RainbowneckEngineering/High-Power-RGBW-LED-Lighting/P-LED-0003-V1A PDF Schematic.pdf

# LED1 PAD

# LED2 PAD

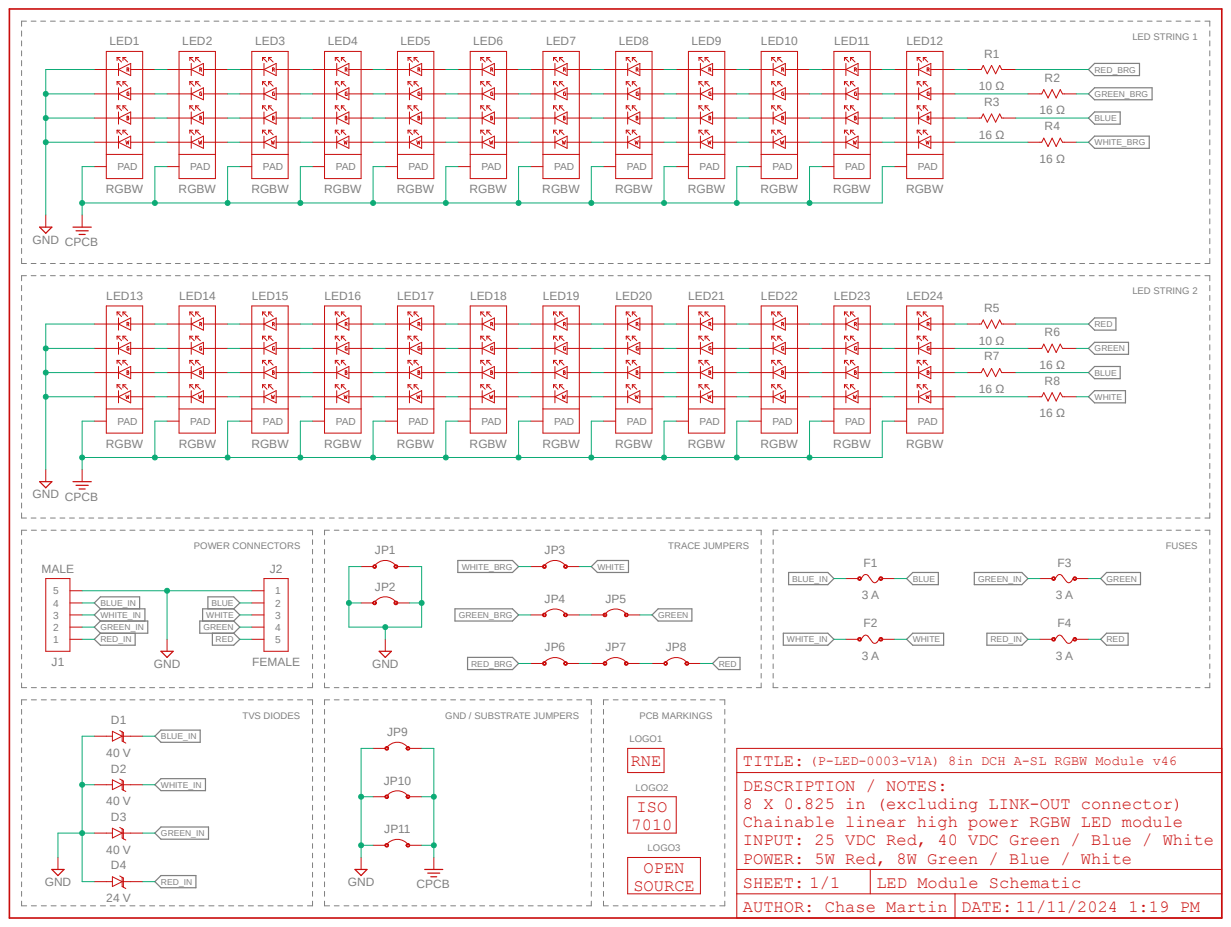
[picture p1: page 1]

TITLE:
DESCRIPTION / NOTES:
8 X 0.825 in (excluding LINK-OUT connector)
Chainable linear high power RGBW LED module
INPUT: 25 VDC Red, 40 VDC Green / Blue / White
POWER: 5W Red, 8W Green / Blue / White

(P-LED-0003-V1A) 8in DCH A-SL RGBW Module v46

SHEET: 1/1 | LED Module Schematic
AUTHOR: Chase Martin | DATE: 11/11/2024 1:19 PM
