RainbowneckEngineering/High-Power-RGBW-LED-Lighting/P-LED-0004-V1A PDF Schematic.pdf

## LED1 PAD

## LED2 PAD

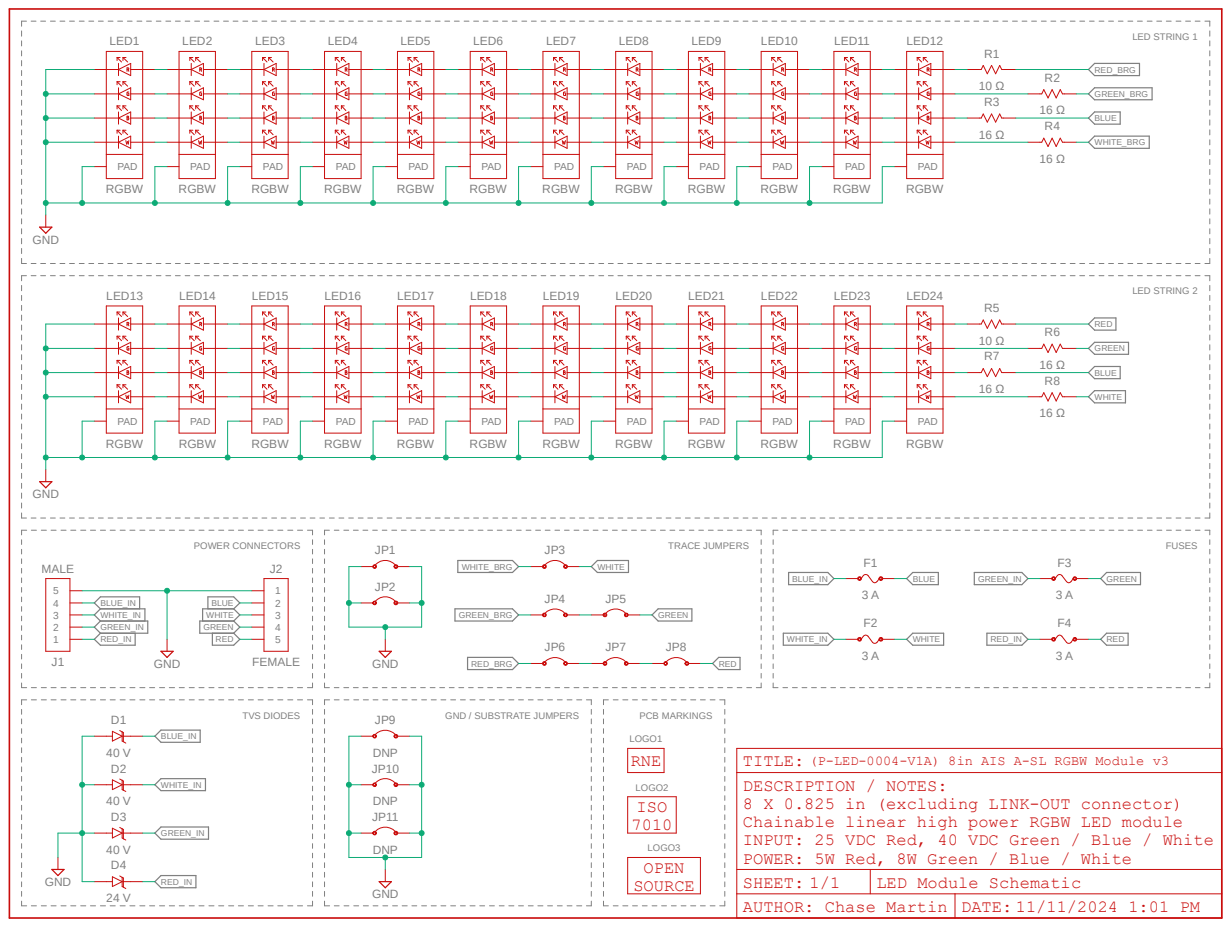
[picture p2: page 1]
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

(P-LED-0004-V1A) 8in AIS A-SL RGBW Module v3

SHEET: 1/1 | LED Module Schematic
AUTHOR: Chase Martin | DATE: 11/11/2024 1:01 PM
