RainbowneckEngineering/High-Power-RGBW-LED-Lighting/P-LED-0003-V1A EAGLE Board.brd

## EAGLE design P-LED-0003-V1A EAGLE Board.brd (2024-11-11)

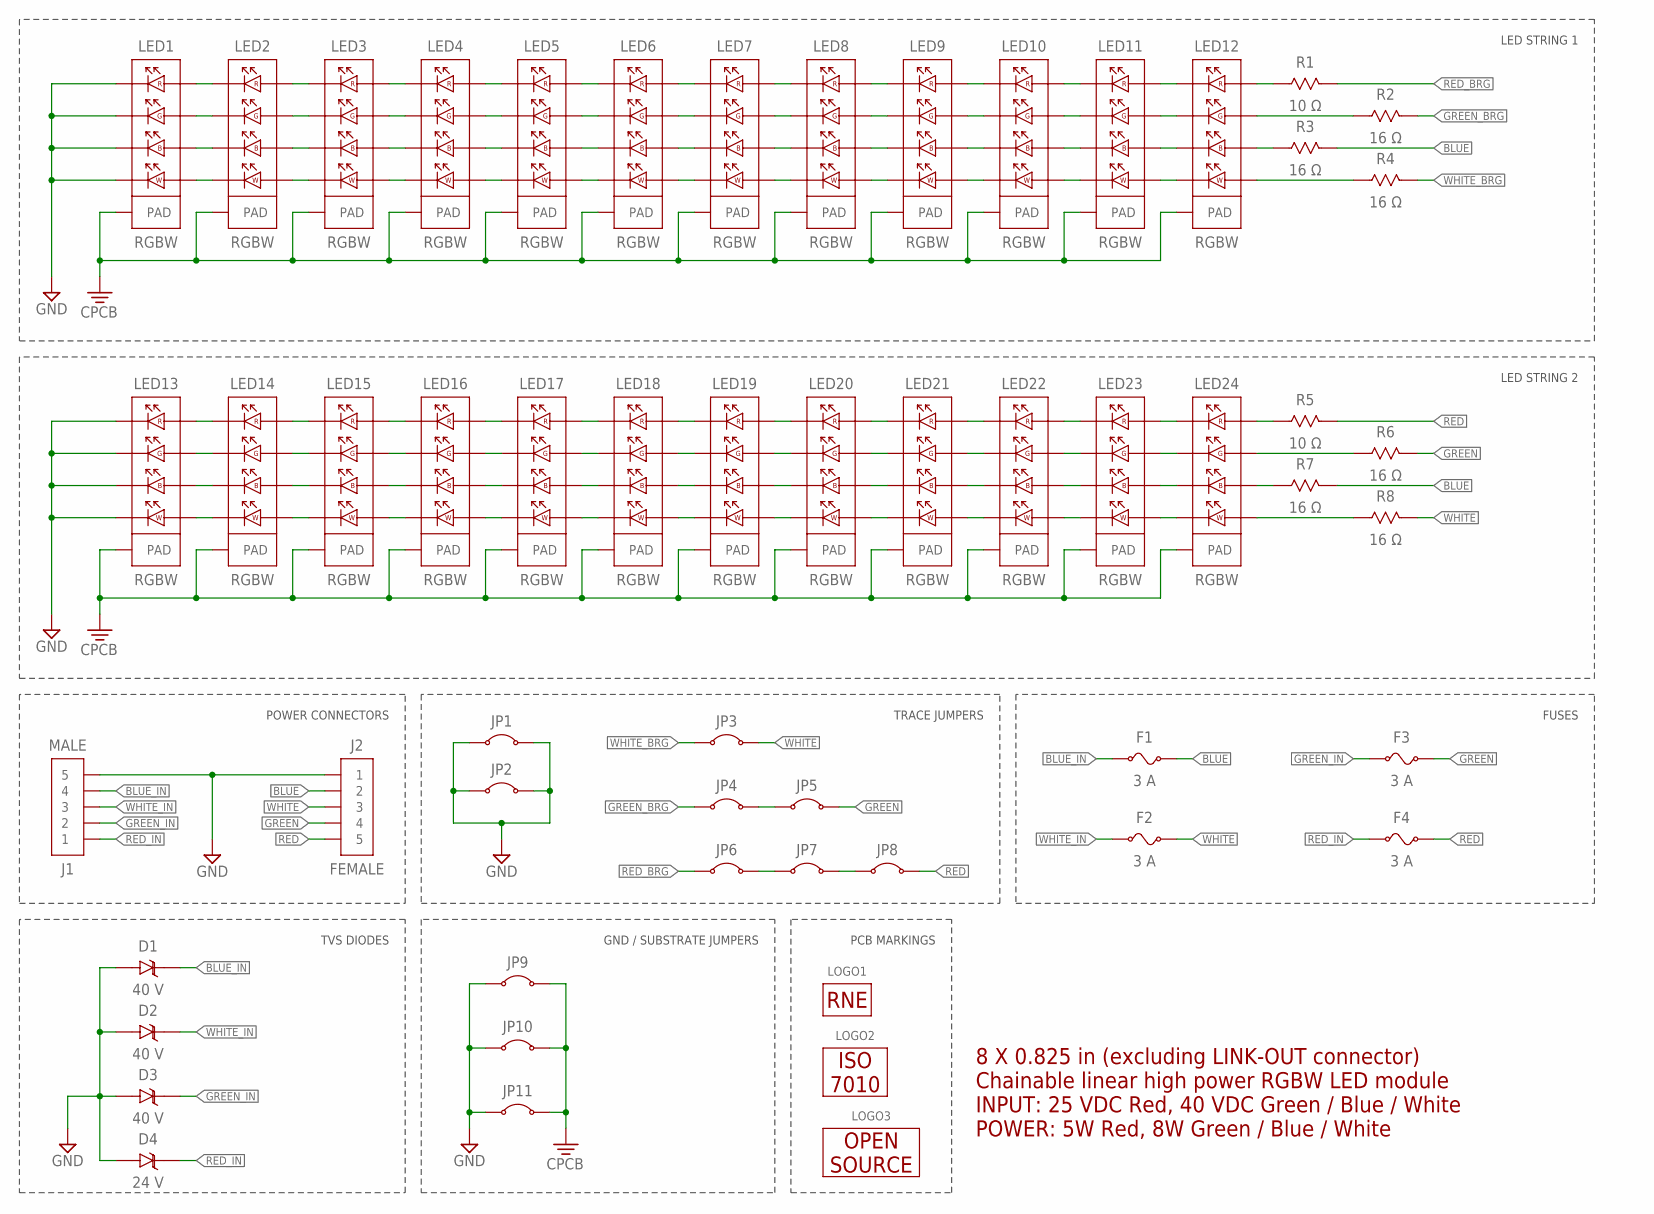
[picture p4: schematic P-LED-0003-V1A EAGLE Schematic.sch, LED Module Schematic]

Parts:
D1, D2, D3: 40 V; 0603_POLARIZED
D4: 24 V; 0603_POLARIZED
F1, F2, F3, F4: 3 A; 1206
J1: MALE; 5-PIN_1-ROW_MALE_SMD_HORIZONTAL
J2: FEMALE; 5-PIN_1-ROW_FEMALE_SMD_HORIZONTAL
JP1, JP2, JP3, JP4, JP5, JP6, JP7, JP8: JUMPERSMD_1206; 1206
JP9, JP10, JP11: DCH_JUMPERSMD_0603; 0603
LED1, LED2, LED3, LED4, LED5, LED6, LED7, LED8, LED9, LED10, LED11, LED12, LED13, LED14, LED15, LED16, LED17, LED18, LED19, LED20, LED21, LED22, LED23, LED24: RGBW; IN-P55QSTGRGBW
LOGO1: PROFILE_LOGO_RNE0.375"; RNE_PROFILE-LOGO_375
LOGO2: HOT_SURFACE_ISO0.375"_LABEL; ISO_HOT-SURFACE_375_LABEL
LOGO3: OPEN_SOURCE_OSHWA0.375"_LABEL; OSHWA_OPEN-SOURCE_375_LABEL
R1, R5: 10 Ω; 0603
R2, R3, R4, R6, R7, R8: 16 Ω; 0603

Connections:
B1_RESISTOR: LED12.BLUE_P, R3.1
B2_RESISTOR: LED24.BLUE_P, R7.1
BLUE: F1.2, J2.2, R3.2, R7.2
BLUE_IN: D1.K, F1.1, J1.4
B_12: LED1.BLUE_P, LED2.BLUE_N
B_23: LED2.BLUE_P, LED3.BLUE_N
B_34: LED3.BLUE_P, LED4.BLUE_N
B_45: LED4.BLUE_P, LED5.BLUE_N
B_56: LED5.BLUE_P, LED6.BLUE_N
B_67: LED6.BLUE_P, LED7.BLUE_N
B_78: LED7.BLUE_P, LED8.BLUE_N
B_89: LED8.BLUE_P, LED9.BLUE_N
B_910: LED9.BLUE_P, LED10.BLUE_N
B_1011: LED10.BLUE_P, LED11.BLUE_N
B_1112: LED11.BLUE_P, LED12.BLUE_N
B_1314: LED13.BLUE_P, LED14.BLUE_N
B_1415: LED14.BLUE_P, LED15.BLUE_N
B_1516: LED15.BLUE_P, LED16.BLUE_N
B_1617: LED16.BLUE_P, LED17.BLUE_N
B_1718: LED17.BLUE_P, LED18.BLUE_N
B_1819: LED18.BLUE_P, LED19.BLUE_N
B_1920: LED19.BLUE_P, LED20.BLUE_N
B_2021: LED20.BLUE_P, LED21.BLUE_N
B_2122: LED21.BLUE_P, LED22.BLUE_N
B_2223: LED22.BLUE_P, LED23.BLUE_N
B_2324: LED23.BLUE_P, LED24.BLUE_N
G1_RESISTOR: LED12.GREEN_P, R2.1
G2_RESISTOR: LED24.GREEN_P, R6.1
GREEN: F3.2, J2.4, JP5.2, R6.2
GREEN_BRG: JP4.1, R2.2
GREEN_BRG_2: JP4.2, JP5.1
GREEN_IN: D3.K, F3.1, J1.2
G_12: LED1.GREEN_P, LED2.GREEN_N
G_23: LED2.GREEN_P, LED3.GREEN_N
G_34: LED3.GREEN_P, LED4.GREEN_N
G_45: LED4.GREEN_P, LED5.GREEN_N
G_56: LED5.GREEN_P, LED6.GREEN_N
G_67: LED6.GREEN_P, LED7.GREEN_N
G_78: LED7.GREEN_P, LED8.GREEN_N
G_89: LED8.GREEN_P, LED9.GREEN_N
G_910: LED9.GREEN_P, LED10.GREEN_N
G_1011: LED10.GREEN_P, LED11.GREEN_N
G_1112: LED11.GREEN_P, LED12.GREEN_N
G_1314: LED13.GREEN_P, LED14.GREEN_N
G_1415: LED14.GREEN_P, LED15.GREEN_N
G_1516: LED15.GREEN_P, LED16.GREEN_N
G_1617: LED16.GREEN_P, LED17.GREEN_N
G_1718: LED17.GREEN_P, LED18.GREEN_N
G_1819: LED18.GREEN_P, LED19.GREEN_N
G_1920: LED19.GREEN_P, LED20.GREEN_N
G_2021: LED20.GREEN_P, LED21.GREEN_N
G_2122: LED21.GREEN_P, LED22.GREEN_N
G_2223: LED22.GREEN_P, LED23.GREEN_N
G_2324: LED23.GREEN_P, LED24.GREEN_N
R1_RESISTOR: LED12.RED_P, R1.1
R2_RESISTOR: LED24.RED_P, R5.1
RED: F4.2, J2.5, JP8.2, R5.2
RED_BRG: JP6.1, R1.2
RED_BRG_2: JP6.2, JP7.1
RED_BRG_3: JP7.2, JP8.1
RED_IN: D4.K, F4.1, J1.1
R_12: LED1.RED_P, LED2.RED_N
R_23: LED2.RED_P, LED3.RED_N
R_34: LED3.RED_P, LED4.RED_N
R_45: LED4.RED_P, LED5.RED_N
R_56: LED5.RED_P, LED6.RED_N
R_67: LED6.RED_P, LED7.RED_N
R_78: LED7.RED_P, LED8.RED_N
R_89: LED8.RED_P, LED9.RED_N
R_910: LED9.RED_P, LED10.RED_N
R_1011: LED10.RED_P, LED11.RED_N
R_1112: LED11.RED_P, LED12.RED_N
R_1314: LED13.RED_P, LED14.RED_N
R_1415: LED14.RED_P, LED15.RED_N
R_1516: LED15.RED_P, LED16.RED_N
R_1617: LED16.RED_P, LED17.RED_N
R_1718: LED17.RED_P, LED18.RED_N
R_1819: LED18.RED_P, LED19.RED_N
R_1920: LED19.RED_P, LED20.RED_N
R_2021: LED20.RED_P, LED21.RED_N
R_2122: LED21.RED_P, LED22.RED_N
R_2223: LED22.RED_P, LED23.RED_N
R_2324: LED23.RED_P, LED24.RED_N
W1_RESISTOR: LED12.WHITE_P, R4.1
W2_RESISTOR: LED24.WHITE_P, R8.1
WHITE: F2.2, J2.3, JP3.2, R8.2
WHITE_BRG: JP3.1, R4.2
WHITE_IN: D2.K, F2.1, J1.3
W_12: LED1.WHITE_P, LED2.WHITE_N
W_23: LED2.WHITE_P, LED3.WHITE_N
W_34: LED3.WHITE_P, LED4.WHITE_N
W_45: LED4.WHITE_P, LED5.WHITE_N
W_56: LED5.WHITE_P, LED6.WHITE_N
W_67: LED6.WHITE_P, LED7.WHITE_N
W_78: LED7.WHITE_P, LED8.WHITE_N
W_89: LED8.WHITE_P, LED9.WHITE_N
W_910: LED9.WHITE_P, LED10.WHITE_N
W_1011: LED10.WHITE_P, LED11.WHITE_N
W_1112: LED11.WHITE_P, LED12.WHITE_N
W_1314: LED13.WHITE_P, LED14.WHITE_N
W_1415: LED14.WHITE_P, LED15.WHITE_N
W_1516: LED15.WHITE_P, LED16.WHITE_N
W_1617: LED16.WHITE_P, LED17.WHITE_N
W_1718: LED17.WHITE_P, LED18.WHITE_N
W_1819: LED18.WHITE_P, LED19.WHITE_N
W_1920: LED19.WHITE_P, LED20.WHITE_N
W_2021: LED20.WHITE_P, LED21.WHITE_N
W_2122: LED21.WHITE_P, LED22.WHITE_N
W_2223: LED22.WHITE_P, LED23.WHITE_N
W_2324: LED23.WHITE_P, LED24.WHITE_N

Notes on the sheet:
LED STRING 1
LED STRING 2
POWER CONNECTORS
TRACE JUMPERS
TVS DIODES
GND / SUBSTRATE JUMPERS
FUSES
8 X 0.825 in (excluding LINK-OUT connector) Chainable linear high power RGBW LED module INPUT: 25 VDC Red, 40 VDC Green / Blue / White POWER: 5W Red, 8W Green / Blue / White
PCB MARKINGS

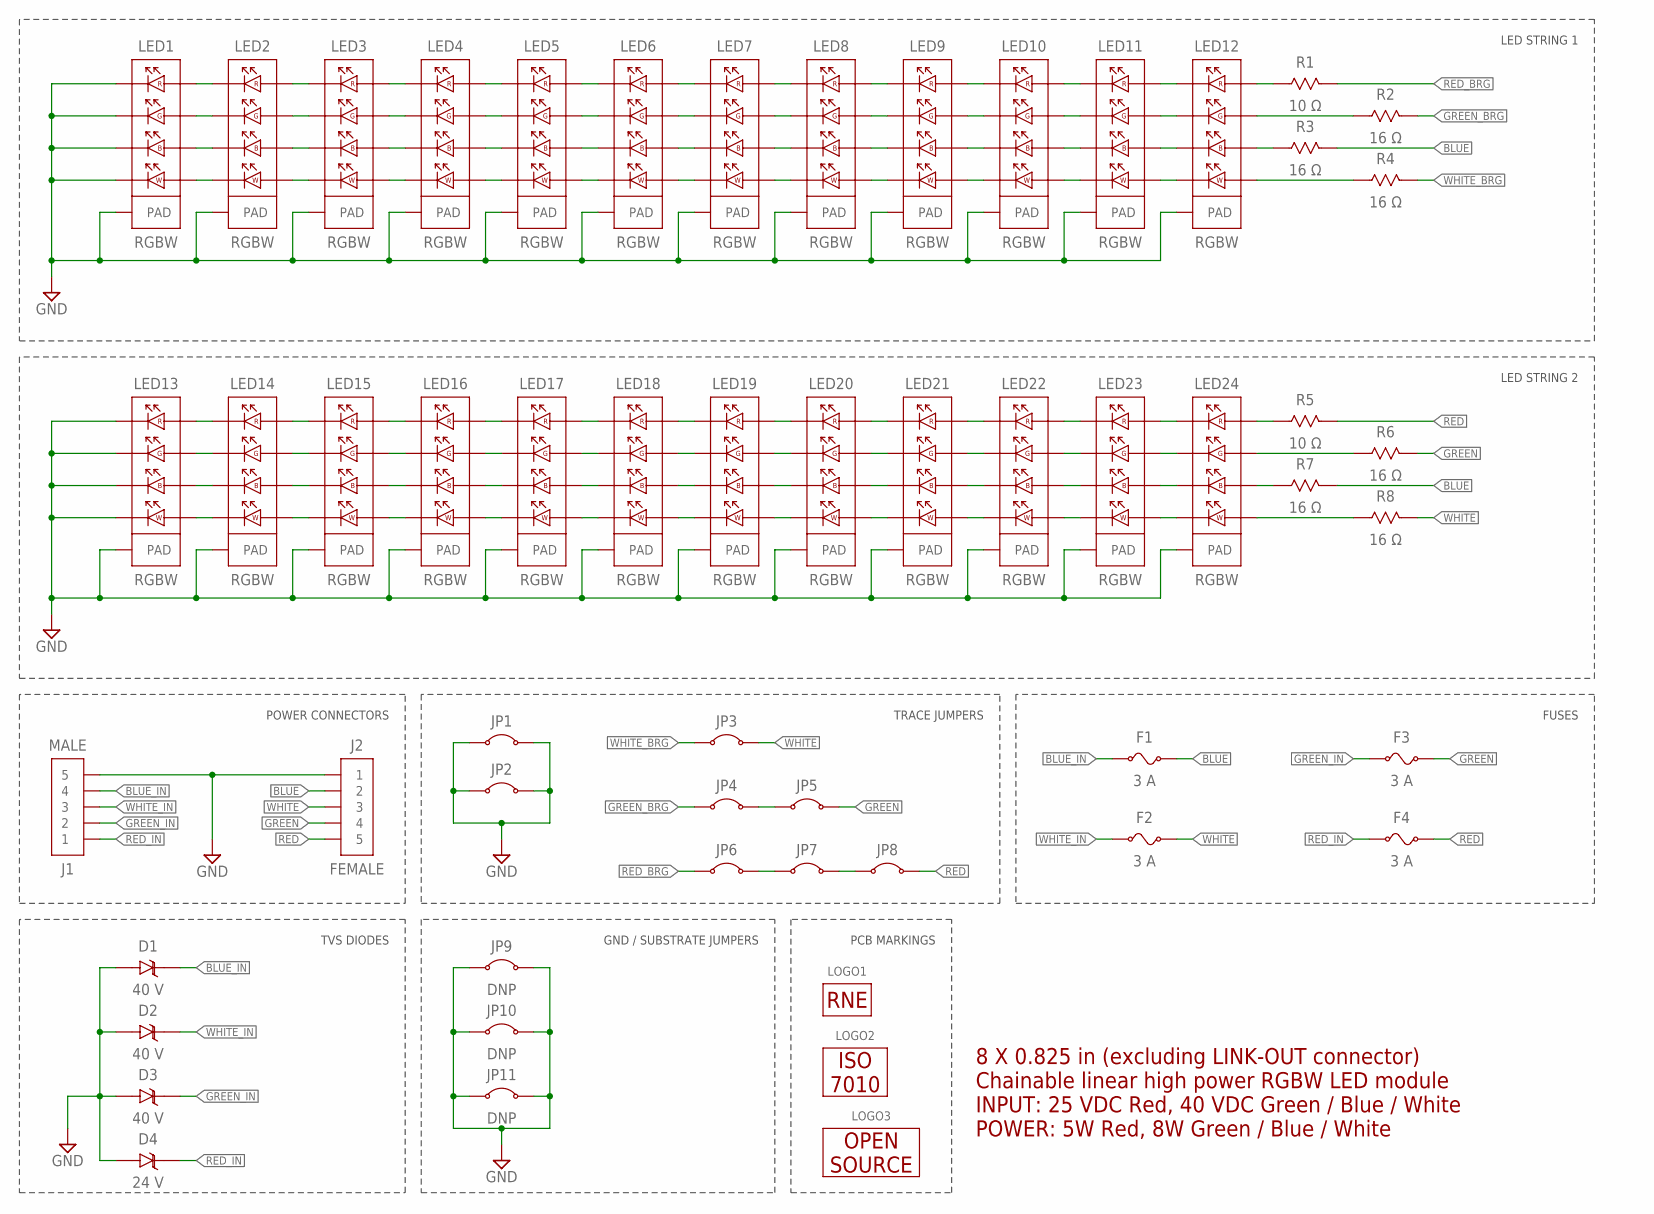
[picture p5: schematic P-LED-0004-V1A EAGLE Schematic.sch, LED Module Schematic]

Parts:
D1, D2, D3: 40 V; 0603_POLARIZED
D4: 24 V; 0603_POLARIZED
F1, F2, F3, F4: 3 A; 1206
J1: MALE; 5-PIN_1-ROW_MALE_SMD_HORIZONTAL
J2: FEMALE; 5-PIN_1-ROW_FEMALE_SMD_HORIZONTAL
JP1, JP2, JP3, JP4, JP5, JP6, JP7, JP8: JUMPERSMD_1206; 1206
JP9, JP10, JP11: DNP; 0603
LED1, LED2, LED3, LED4, LED5, LED6, LED7, LED8, LED9, LED10, LED11, LED12, LED13, LED14, LED15, LED16, LED17, LED18, LED19, LED20, LED21, LED22, LED23, LED24: RGBW; IN-P55QSTGRGBW_AIS
LOGO1: PROFILE_LOGO_RNE0.375"; RNE_PROFILE-LOGO_375
LOGO2: HOT_SURFACE_ISO0.375"_LABEL; ISO_HOT-SURFACE_375_LABEL
LOGO3: OPEN_SOURCE_OSHWA0.375"_LABEL; OSHWA_OPEN-SOURCE_375_LABEL
R1, R5: 10 Ω; 0603
R2, R3, R4, R6, R7, R8: 16 Ω; 0603

Connections:
B1_RESISTOR: LED12.BLUE_P, R3.1
B2_RESISTOR: LED24.BLUE_P, R7.1
BLUE: F1.2, J2.2, R3.2, R7.2
BLUE_IN: D1.K, F1.1, J1.4
B_12: LED1.BLUE_P, LED2.BLUE_N
B_23: LED2.BLUE_P, LED3.BLUE_N
B_34: LED3.BLUE_P, LED4.BLUE_N
B_45: LED4.BLUE_P, LED5.BLUE_N
B_56: LED5.BLUE_P, LED6.BLUE_N
B_67: LED6.BLUE_P, LED7.BLUE_N
B_78: LED7.BLUE_P, LED8.BLUE_N
B_89: LED8.BLUE_P, LED9.BLUE_N
B_910: LED9.BLUE_P, LED10.BLUE_N
B_1011: LED10.BLUE_P, LED11.BLUE_N
B_1112: LED11.BLUE_P, LED12.BLUE_N
B_1314: LED13.BLUE_P, LED14.BLUE_N
B_1415: LED14.BLUE_P, LED15.BLUE_N
B_1516: LED15.BLUE_P, LED16.BLUE_N
B_1617: LED16.BLUE_P, LED17.BLUE_N
B_1718: LED17.BLUE_P, LED18.BLUE_N
B_1819: LED18.BLUE_P, LED19.BLUE_N
B_1920: LED19.BLUE_P, LED20.BLUE_N
B_2021: LED20.BLUE_P, LED21.BLUE_N
B_2122: LED21.BLUE_P, LED22.BLUE_N
B_2223: LED22.BLUE_P, LED23.BLUE_N
B_2324: LED23.BLUE_P, LED24.BLUE_N
G1_RESISTOR: LED12.GREEN_P, R2.1
G2_RESISTOR: LED24.GREEN_P, R6.1
GREEN: F3.2, J2.4, JP5.2, R6.2
GREEN_BRG: JP4.1, R2.2
GREEN_BRG_2: JP4.2, JP5.1
GREEN_IN: D3.K, F3.1, J1.2
G_12: LED1.GREEN_P, LED2.GREEN_N
G_23: LED2.GREEN_P, LED3.GREEN_N
G_34: LED3.GREEN_P, LED4.GREEN_N
G_45: LED4.GREEN_P, LED5.GREEN_N
G_56: LED5.GREEN_P, LED6.GREEN_N
G_67: LED6.GREEN_P, LED7.GREEN_N
G_78: LED7.GREEN_P, LED8.GREEN_N
G_89: LED8.GREEN_P, LED9.GREEN_N
G_910: LED9.GREEN_P, LED10.GREEN_N
G_1011: LED10.GREEN_P, LED11.GREEN_N
G_1112: LED11.GREEN_P, LED12.GREEN_N
G_1314: LED13.GREEN_P, LED14.GREEN_N
G_1415: LED14.GREEN_P, LED15.GREEN_N
G_1516: LED15.GREEN_P, LED16.GREEN_N
G_1617: LED16.GREEN_P, LED17.GREEN_N
G_1718: LED17.GREEN_P, LED18.GREEN_N
G_1819: LED18.GREEN_P, LED19.GREEN_N
G_1920: LED19.GREEN_P, LED20.GREEN_N
G_2021: LED20.GREEN_P, LED21.GREEN_N
G_2122: LED21.GREEN_P, LED22.GREEN_N
G_2223: LED22.GREEN_P, LED23.GREEN_N
G_2324: LED23.GREEN_P, LED24.GREEN_N
R1_RESISTOR: LED12.RED_P, R1.1
R2_RESISTOR: LED24.RED_P, R5.1
RED: F4.2, J2.5, JP8.2, R5.2
RED_BRG: JP6.1, R1.2
RED_BRG_2: JP6.2, JP7.1
RED_BRG_3: JP7.2, JP8.1
RED_IN: D4.K, F4.1, J1.1
R_12: LED1.RED_P, LED2.RED_N
R_23: LED2.RED_P, LED3.RED_N
R_34: LED3.RED_P, LED4.RED_N
R_45: LED4.RED_P, LED5.RED_N
R_56: LED5.RED_P, LED6.RED_N
R_67: LED6.RED_P, LED7.RED_N
R_78: LED7.RED_P, LED8.RED_N
R_89: LED8.RED_P, LED9.RED_N
R_910: LED9.RED_P, LED10.RED_N
R_1011: LED10.RED_P, LED11.RED_N
R_1112: LED11.RED_P, LED12.RED_N
R_1314: LED13.RED_P, LED14.RED_N
R_1415: LED14.RED_P, LED15.RED_N
R_1516: LED15.RED_P, LED16.RED_N
R_1617: LED16.RED_P, LED17.RED_N
R_1718: LED17.RED_P, LED18.RED_N
R_1819: LED18.RED_P, LED19.RED_N
R_1920: LED19.RED_P, LED20.RED_N
R_2021: LED20.RED_P, LED21.RED_N
R_2122: LED21.RED_P, LED22.RED_N
R_2223: LED22.RED_P, LED23.RED_N
R_2324: LED23.RED_P, LED24.RED_N
W1_RESISTOR: LED12.WHITE_P, R4.1
W2_RESISTOR: LED24.WHITE_P, R8.1
WHITE: F2.2, J2.3, JP3.2, R8.2
WHITE_BRG: JP3.1, R4.2
WHITE_IN: D2.K, F2.1, J1.3
W_12: LED1.WHITE_P, LED2.WHITE_N
W_23: LED2.WHITE_P, LED3.WHITE_N
W_34: LED3.WHITE_P, LED4.WHITE_N
W_45: LED4.WHITE_P, LED5.WHITE_N
W_56: LED5.WHITE_P, LED6.WHITE_N
W_67: LED6.WHITE_P, LED7.WHITE_N
W_78: LED7.WHITE_P, LED8.WHITE_N
W_89: LED8.WHITE_P, LED9.WHITE_N
W_910: LED9.WHITE_P, LED10.WHITE_N
W_1011: LED10.WHITE_P, LED11.WHITE_N
W_1112: LED11.WHITE_P, LED12.WHITE_N
W_1314: LED13.WHITE_P, LED14.WHITE_N
W_1415: LED14.WHITE_P, LED15.WHITE_N
W_1516: LED15.WHITE_P, LED16.WHITE_N
W_1617: LED16.WHITE_P, LED17.WHITE_N
W_1718: LED17.WHITE_P, LED18.WHITE_N
W_1819: LED18.WHITE_P, LED19.WHITE_N
W_1920: LED19.WHITE_P, LED20.WHITE_N
W_2021: LED20.WHITE_P, LED21.WHITE_N
W_2122: LED21.WHITE_P, LED22.WHITE_N
W_2223: LED22.WHITE_P, LED23.WHITE_N
W_2324: LED23.WHITE_P, LED24.WHITE_N

Notes on the sheet:
LED STRING 1
LED STRING 2
POWER CONNECTORS
TRACE JUMPERS
TVS DIODES
GND / SUBSTRATE JUMPERS
FUSES
8 X 0.825 in (excluding LINK-OUT connector) Chainable linear high power RGBW LED module INPUT: 25 VDC Red, 40 VDC Green / Blue / White POWER: 5W Red, 8W Green / Blue / White
PCB MARKINGS


Parts:
D1, D2, D3: 40 V; 0603_POLARIZED
D4: 24 V; 0603_POLARIZED
F1, F2, F3, F4: 3 A; 1206
J1: MALE; 5-PIN_1-ROW_MALE_SMD_HORIZONTAL
J2: FEMALE; 5-PIN_1-ROW_FEMALE_SMD_HORIZONTAL
JP1, JP2, JP3, JP4, JP5, JP6, JP7, JP8: JUMPERSMD_1206; 1206
JP9, JP10, JP11: DNP; 0603
LED1, LED2, LED3, LED4, LED5, LED6, LED7, LED8, LED9, LED10, LED11, LED12, LED13, LED14, LED15, LED16, LED17, LED18, LED19, LED20, LED21, LED22, LED23, LED24: RGBW; IN-P55QSTGRGBW_FR4
LOGO1: PROFILE_LOGO_RNE0.375"; RNE_PROFILE-LOGO_375
LOGO2: HOT_SURFACE_ISO0.375"_LABEL; ISO_HOT-SURFACE_375_LABEL
LOGO3: OPEN_SOURCE_OSHWA0.375"_LABEL; OSHWA_OPEN-SOURCE_375_LABEL
R1, R5: 10 Ω; 0603
R2, R3, R4, R6, R7, R8: 16 Ω; 0603

Connections:
B1_RESISTOR: LED12.BLUE_P, R3.1
B2_RESISTOR: LED24.BLUE_P, R7.1
BLUE: F1.2, J2.2, R3.2, R7.2
BLUE_IN: D1.K, F1.1, J1.4
B_12: LED1.BLUE_P, LED2.BLUE_N
B_23: LED2.BLUE_P, LED3.BLUE_N
B_34: LED3.BLUE_P, LED4.BLUE_N
B_45: LED4.BLUE_P, LED5.BLUE_N
B_56: LED5.BLUE_P, LED6.BLUE_N
B_67: LED6.BLUE_P, LED7.BLUE_N
B_78: LED7.BLUE_P, LED8.BLUE_N
B_89: LED8.BLUE_P, LED9.BLUE_N
B_910: LED9.BLUE_P, LED10.BLUE_N
B_1011: LED10.BLUE_P, LED11.BLUE_N
B_1112: LED11.BLUE_P, LED12.BLUE_N
B_1314: LED13.BLUE_P, LED14.BLUE_N
B_1415: LED14.BLUE_P, LED15.BLUE_N
B_1516: LED15.BLUE_P, LED16.BLUE_N
B_1617: LED16.BLUE_P, LED17.BLUE_N
B_1718: LED17.BLUE_P, LED18.BLUE_N
B_1819: LED18.BLUE_P, LED19.BLUE_N
B_1920: LED19.BLUE_P, LED20.BLUE_N
B_2021: LED20.BLUE_P, LED21.BLUE_N
B_2122: LED21.BLUE_P, LED22.BLUE_N
B_2223: LED22.BLUE_P, LED23.BLUE_N
B_2324: LED23.BLUE_P, LED24.BLUE_N
G1_RESISTOR: LED12.GREEN_P, R2.1
G2_RESISTOR: LED24.GREEN_P, R6.1
GREEN: F3.2, J2.4, JP5.2, R6.2
GREEN_BRG: JP4.1, R2.2
GREEN_BRG_2: JP4.2, JP5.1
GREEN_IN: D3.K, F3.1, J1.2
G_12: LED1.GREEN_P, LED2.GREEN_N
G_23: LED2.GREEN_P, LED3.GREEN_N
G_34: LED3.GREEN_P, LED4.GREEN_N
G_45: LED4.GREEN_P, LED5.GREEN_N
G_56: LED5.GREEN_P, LED6.GREEN_N
G_67: LED6.GREEN_P, LED7.GREEN_N
G_78: LED7.GREEN_P, LED8.GREEN_N
G_89: LED8.GREEN_P, LED9.GREEN_N
G_910: LED9.GREEN_P, LED10.GREEN_N
G_1011: LED10.GREEN_P, LED11.GREEN_N
G_1112: LED11.GREEN_P, LED12.GREEN_N
G_1314: LED13.GREEN_P, LED14.GREEN_N
G_1415: LED14.GREEN_P, LED15.GREEN_N
G_1516: LED15.GREEN_P, LED16.GREEN_N
G_1617: LED16.GREEN_P, LED17.GREEN_N
G_1718: LED17.GREEN_P, LED18.GREEN_N
G_1819: LED18.GREEN_P, LED19.GREEN_N
G_1920: LED19.GREEN_P, LED20.GREEN_N
G_2021: LED20.GREEN_P, LED21.GREEN_N
G_2122: LED21.GREEN_P, LED22.GREEN_N
G_2223: LED22.GREEN_P, LED23.GREEN_N
G_2324: LED23.GREEN_P, LED24.GREEN_N
R1_RESISTOR: LED12.RED_P, R1.1
R2_RESISTOR: LED24.RED_P, R5.1
RED: F4.2, J2.5, JP8.2, R5.2
RED_BRG: JP6.1, R1.2
RED_BRG_2: JP6.2, JP7.1
RED_BRG_3: JP7.2, JP8.1
RED_IN: D4.K, F4.1, J1.1
R_12: LED1.RED_P, LED2.RED_N
R_23: LED2.RED_P, LED3.RED_N
R_34: LED3.RED_P, LED4.RED_N
R_45: LED4.RED_P, LED5.RED_N
R_56: LED5.RED_P, LED6.RED_N
R_67: LED6.RED_P, LED7.RED_N
R_78: LED7.RED_P, LED8.RED_N
R_89: LED8.RED_P, LED9.RED_N
R_910: LED9.RED_P, LED10.RED_N
R_1011: LED10.RED_P, LED11.RED_N
R_1112: LED11.RED_P, LED12.RED_N
R_1314: LED13.RED_P, LED14.RED_N
R_1415: LED14.RED_P, LED15.RED_N
R_1516: LED15.RED_P, LED16.RED_N
R_1617: LED16.RED_P, LED17.RED_N
R_1718: LED17.RED_P, LED18.RED_N
R_1819: LED18.RED_P, LED19.RED_N
R_1920: LED19.RED_P, LED20.RED_N
R_2021: LED20.RED_P, LED21.RED_N
R_2122: LED21.RED_P, LED22.RED_N
R_2223: LED22.RED_P, LED23.RED_N
R_2324: LED23.RED_P, LED24.RED_N
W1_RESISTOR: LED12.WHITE_P, R4.1
W2_RESISTOR: LED24.WHITE_P, R8.1
WHITE: F2.2, J2.3, JP3.2, R8.2
WHITE_BRG: JP3.1, R4.2
WHITE_IN: D2.K, F2.1, J1.3
W_12: LED1.WHITE_P, LED2.WHITE_N
W_23: LED2.WHITE_P, LED3.WHITE_N
W_34: LED3.WHITE_P, LED4.WHITE_N
W_45: LED4.WHITE_P, LED5.WHITE_N
W_56: LED5.WHITE_P, LED6.WHITE_N
W_67: LED6.WHITE_P, LED7.WHITE_N
W_78: LED7.WHITE_P, LED8.WHITE_N
W_89: LED8.WHITE_P, LED9.WHITE_N
W_910: LED9.WHITE_P, LED10.WHITE_N
W_1011: LED10.WHITE_P, LED11.WHITE_N
W_1112: LED11.WHITE_P, LED12.WHITE_N
W_1314: LED13.WHITE_P, LED14.WHITE_N
W_1415: LED14.WHITE_P, LED15.WHITE_N
W_1516: LED15.WHITE_P, LED16.WHITE_N
W_1617: LED16.WHITE_P, LED17.WHITE_N
W_1718: LED17.WHITE_P, LED18.WHITE_N
W_1819: LED18.WHITE_P, LED19.WHITE_N
W_1920: LED19.WHITE_P, LED20.WHITE_N
W_2021: LED20.WHITE_P, LED21.WHITE_N
W_2122: LED21.WHITE_P, LED22.WHITE_N
W_2223: LED22.WHITE_P, LED23.WHITE_N
W_2324: LED23.WHITE_P, LED24.WHITE_N

Notes on the sheet:
LED STRING 1
LED STRING 2
POWER CONNECTORS
TRACE JUMPERS
TVS DIODES
GND / SUBSTRATE JUMPERS
FUSES
8 X 0.825 in (excluding LINK-OUT connector) Chainable linear high power RGBW LED module INPUT: 25 VDC Red, 40 VDC Green / Blue / White POWER: 5W Red, 8W Green / Blue / White
PCB MARKINGS

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
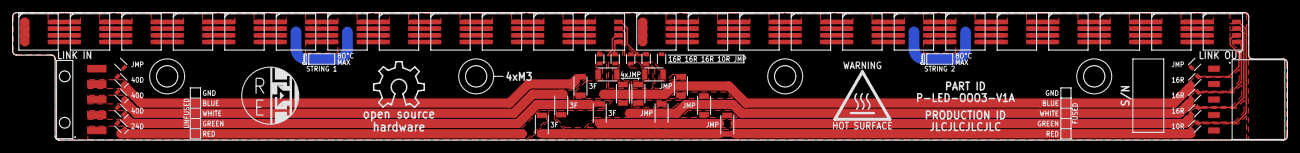
[picture p6: board P-LED-0003-V1A EAGLE Board.brd from above]

Board: 2 copper layers, 209.6 x 21.0 mm, 56 parts (0 on the bottom side), 112 nets.
